SharKingStudios/Tadpole-FPV/images/foorprintupdates.png

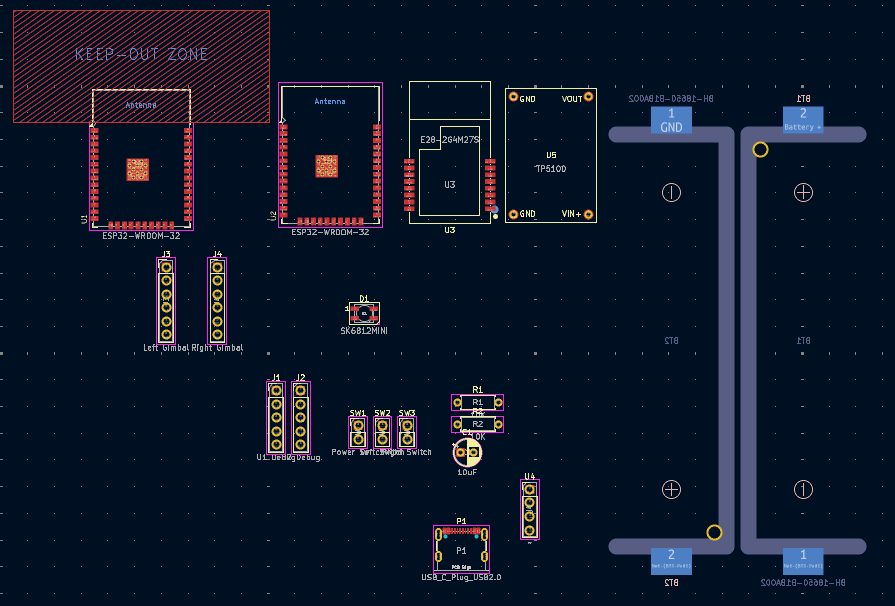
images/foorprintupdates.png
