SharKingStudios/Tadpole-FPV/Tadpole-FPV-PCB/Tadpole-FPV-PCB.kicad_pcb

## KiCad design Tadpole-FPV-PCB/Tadpole-FPV-PCB.kicad_pcb (2025-06-26)

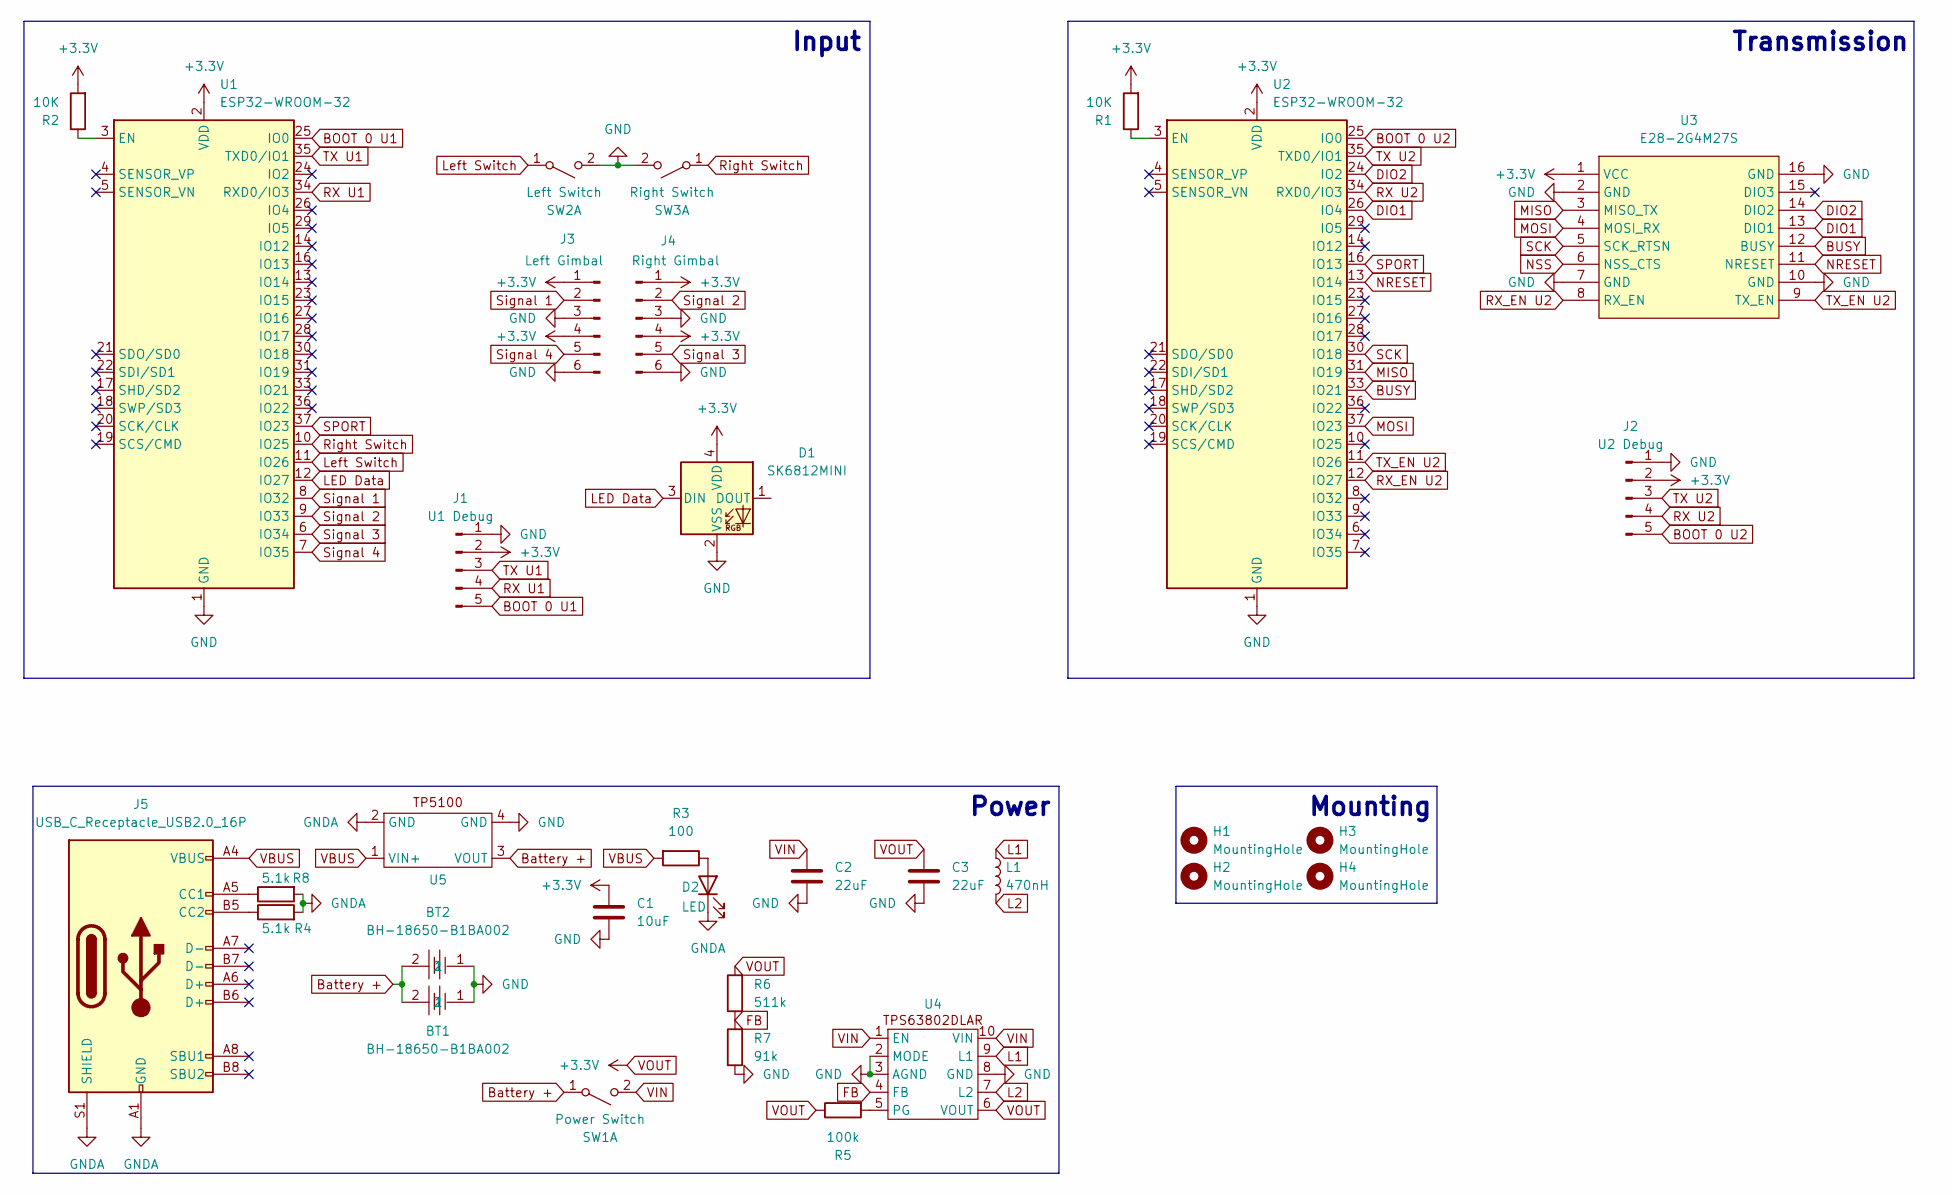
[picture p2: schematic Tadpole-FPV-PCB.kicad_sch, Tadpole FPV Drone Transmitter]

Parts:
BT1, BT2: BH-18650-B1BA002; BATTERY-SMD_18650-1S-L77.1-W20.7-1; LCSC Part C2988620
C1: 10uF; CP_Radial_D5.0mm_P2.50mm
C2, C3: 22uF; C_0603_1608Metric
D1: SK6812MINI; LED_SK6812MINI_PLCC4_3.5x3.5mm_P1.75mm
D2: LED; 0603 LED
H1, H2, H3, H4: MountingHole; MountingHole_3.2mm_M3_Pad_Via
J1: U1 Debug; PinHeader_1x05_P2.54mm_Vertical
J2: U2 Debug; PinHeader_1x05_P2.54mm_Vertical
J3: Left Gimbal; PinHeader_1x06_P2.54mm_Vertical
J4: Right Gimbal; PinHeader_1x06_P2.54mm_Vertical
J5: USB_C_Receptacle_USB2.0_16P; USB_C_Receptacle_GCT_USB4105-xx-A_16P_TopMnt_Horizontal
L1: 470nH; IND-SMD_L4.0-W4.0_XGL4020
R1, R2: 10K; R_0603_1608Metric
R3: 100; R_0603_1608Metric
R4, R8: 5.1k; R_0603_1608Metric
R5: 100k; R_0402_1005Metric
R6: 511k; R_0402_1005Metric
R7: 91k; R_0603_1608Metric
SW1: Power Switch; PinHeader_1x02_P2.54mm_Vertical
SW2: Left Switch; PinHeader_1x02_P2.54mm_Vertical
SW3: Right Switch; PinHeader_1x02_P2.54mm_Vertical
U1, U2: ESP32-WROOM-32
U3: E28-2G4M27S; WIRELM-SMD_E28-2G4M2XS; LCSC Part C411312
U4: VSON-10_L3.0-W2.0-P0.50-TL
U5: TP5100

Connections:
BOOT 0 U1: J1.5, U1.25 (IO0)
BOOT 0 U2: J2.5, U2.25 (IO0)
BUSY: U2.33 (IO21), U3.12 (BUSY)
Battery +: BT1.2, BT2.2, SW1.1 (A), U5.3 (VOUT)
DIO1: U2.26 (IO4), U3.13 (DIO1)
DIO2: U2.24 (IO2), U3.14 (DIO2)
FB: R6.1, R7.2, U4.4 (FB)
GND: BT1.1, BT2.1, C1.2, C2.1, C3.2, D1.2 (VSS), J1.1, J2.1, J3.3, J3.6, J4.3, J4.6, R7.1, SW2.2 (B), SW3.2 (B), U1.1 (GND), U1.15 (GND), U1.38 (GND), U1.39 (GND), U2.1 (GND), U2.15 (GND), U2.38 (GND), U2.39 (GND), U3.2 (GND), U3.7 (GND), U3.10 (GND), U3.16 (GND), U4.2 (MODE), U4.3 (AGND), U4.8 (GND), U5.4 (GND)
GNDA: D2.1 (K), J5.A1 (GND), J5.A12 (GND), J5.B1 (GND), J5.B12 (GND), J5.S1 (SHIELD), R4.2, R8.2, U5.2 (GND)
L1: L1.1, U4.9 (L1)
L2: L1.2, U4.7 (L2)
LED Data: D1.3 (DIN), U1.12 (IO27)
Left Switch: SW2.1 (A), U1.11 (IO26)
MISO: U2.31 (IO19), U3.3 (MISO_TX)
MOSI: U2.37 (IO23), U3.4 (MOSI_RX)
NRESET: U2.13 (IO14), U3.11 (NRESET)
NSS: U3.6 (NSS_CTS)
unnamed: D2.2 (A), R3.1
unnamed: J5.A5 (CC1), R8.1
unnamed: J5.B5 (CC2), R4.1
unnamed: R2.1, U1.3 (EN)
unnamed: R1.1, U2.3 (EN)
unnamed: R5.2, U4.5 (PG)
RX U1: J1.4, U1.34 (RXD0/IO3)
RX U2: J2.4, U2.34 (RXD0/IO3)
RX_EN U2: U2.12 (IO27), U3.8 (RX_EN)
Right Switch: SW3.1 (A), U1.10 (IO25)
SCK: U2.30 (IO18), U3.5 (SCK_RTSN)
SPORT: U1.37 (IO23), U2.16 (IO13)
Signal 1: J3.2, U1.8 (IO32)
Signal 2: J4.2, U1.9 (IO33)
Signal 3: J4.5, U1.6 (IO34)
Signal 4: J3.5, U1.7 (IO35)
TX U1: J1.3, U1.35 (TXD0/IO1)
TX U2: J2.3, U2.35 (TXD0/IO1)
TX_EN U2: U2.11 (IO26), U3.9 (TX_EN)
VBUS: J5.A4 (VBUS), J5.A9 (VBUS), J5.B4 (VBUS), J5.B9 (VBUS), R3.2, U5.1 (VIN+)
VIN: C2.2, SW1.2 (B), U4.1 (EN), U4.10 (VIN)
VOUT: C1.1, C3.1, D1.4 (VDD), J1.2, J2.2, J3.1, J3.4, J4.1, J4.4, R1.2, R2.2, R5.1, R6.2, U1.2 (VDD), U2.2 (VDD), U3.1 (VCC), U4.6 (VOUT)

Notes on the sheet:
Mounting
Transmission
Input
Power

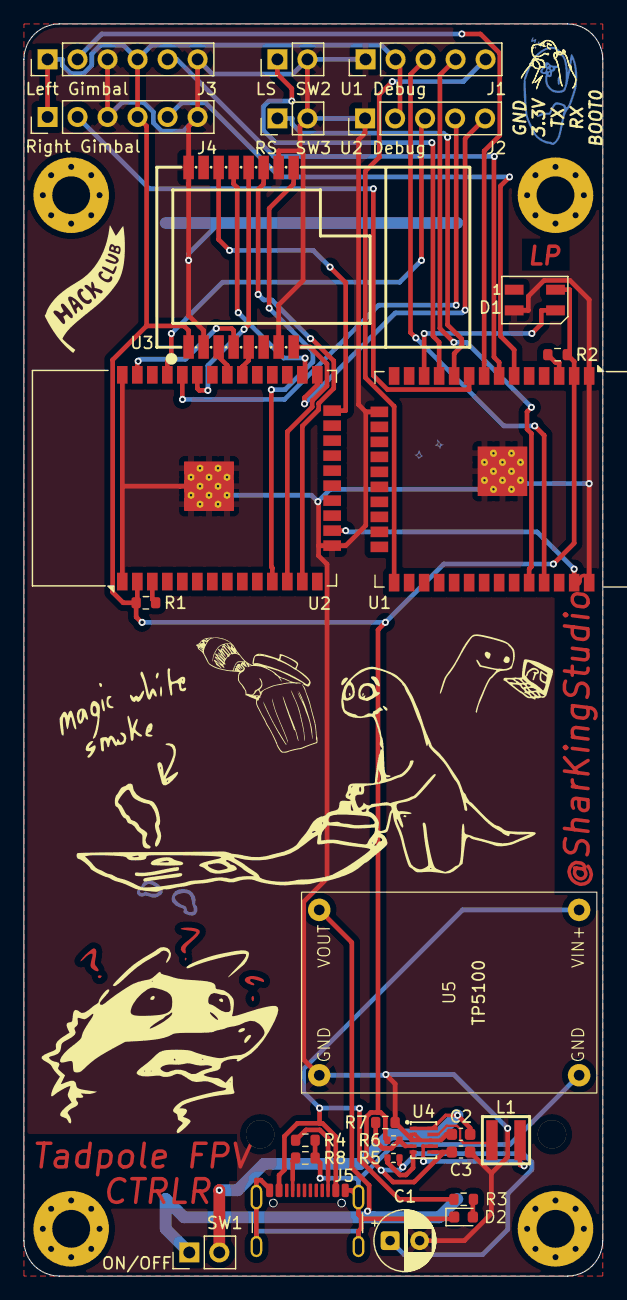
[picture p3: board Tadpole-FPV-PCB.kicad_pcb from above]

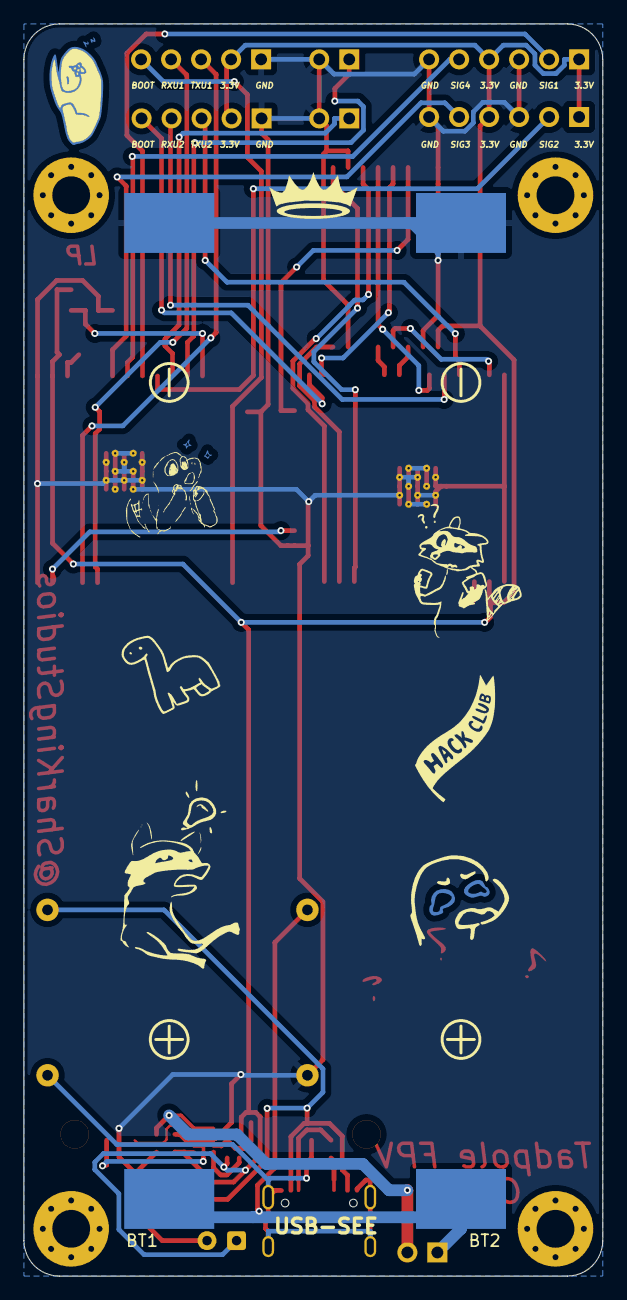
[picture p4: board Tadpole-FPV-PCB.kicad_pcb from below]

Board: 2 copper layers, 49.0 x 106.0 mm, 33 parts (2 on the bottom side), 38 nets.
