SharKingStudios/Tadpole-FPV/(commit log)

2025-06-23 Finished PCB Schematic Design
    Started PCB Design in KiCAD + Finished PCB Schematic Design
    [Tadpole-FPV-PCB.kicad_pcb, Tadpole-FPV-PCB.kicad_sch]
2025-06-24 Finished PCB Schematic Design (Again)
    I feel like this might happen a couple more times...
    [Tadpole-FPV-PCB.kicad_pcb, Tadpole-FPV-PCB.kicad_sch]
2025-06-26 Finished PCB Layout and Wiring + PCB Art!
    Also fixed some layout issues from earlier Journal entries.
    [Tadpole-FPV-PCB.kicad_pcb, Tadpole-FPV-PCB.kicad_sch]
